Mateosmerodes/Mini_Sumo_Robot_LHDLT/README.md

# Mini_Sumo_Robot_LHDLT
Repositorio de informacion y código proyecto minisumo
