Mateosmerodes/Mini_Sumo_Robot_LHDLT/ficha_técnica_robot.docx

#### FICHA TÉCNICA

Nombre del Equipo/Robot: Hombres De Las Tabernas

Licencia de Hardware Libre: [CERN-OHL-P]

Enlace al Repositorio del Proyecto: GitHub (https://github.com/Mateosmerodes/Mini_Sumo_Robot_LHDLT)

#### 2. ESPECIFICACIÓNS MECÁNICAS

Parámetro | Valor Nominal
Dimensiones (ancho x largo x alto) | 9.8 x 9.8 x 5.5 cm
Masa total (con batería) | 420 g
Material do chasis | PCB de FR4, piezas de PetG, cuchilla de acero
Tipo de tracción | 4WD
Superficie de rodas | Silicona

#### 3. SISTEMA ELÉCTRICO Y DE POTENCIA

##### 3.1. Fuente de Alimentación (Batería)

- Tipo: LiPo 2S
- Tensión nominal: 7.4 (2*3.7) V
- Tensión máxima a plena carga: 8.4 V
- Capacidad: 4.50 mAh
- Tasa de descarga (C-Rating): [30] C
- Protección Eléctrica: MOSFET P AOD4185 contra inversión de polaridad · fusible rápido de 10 A (2512) · limitación de corriente por hardware en cada driver (ITRIP ≈ 2,4 A) · medida de tensión de batería (divisor 100 k / 33 k al ADC) para el aviso de batería baja (3,3 V por celda) · apagado por subtensión y temperatura en los drivers

##### 3.2. Actuadores (Motores y Drivers)

- Modelo / Tipo de motor: N20 Micro motoreductor
- Tensión de trabajo: [6,6–8,4] V
- Consumo a bloqueo (Stall Current): 2,2 A a 8,4 V por motor
- Controlador de motores (Driver): TI DRV8874
- Rango de tensiones admitidas (Driver): 4,5–37 V
- Corriente máxima soportada por canal: 2.1 A continuos / 6 A pico

##### 3.3. Consumo Eléctrico Estimado

- Potencia máxima calculada: 79 W
- Autonomía estimada en combate continuo: 5 minutos
- Fundamento del cálculo de autonomía:

#### 4. SISTEMA DE CONTROL Y SENSADO

Descripción elemento | Tipo / Modelo | Tensiones Admitidas y de Operación | Corriente nominal
Placa de Control Abierta | Espressif ESP32-S3-DevKitC-1 | 5 V | 100mA
Módulo del Receptor IR | VS1838B / TSOP38238 | 3.3 V | 1mA
Sensores de Borde (Línea) | QRE1113 analógico (módulo), × 4: 2 delante y 2 detrás | 3.3 V | 21mA
Sensores de Oponente | VL53L0X ToF (módulo GY-VL53L0XV2), × 6: 3 frontales, 2 laterales, 1 trasero | 3.3 V | 19mA
…

#### 5. INSPECCIÓN REGULATORIA Y SEGURIDAD

Criterio | Estado | Notas del Inspector
1. Dispositivos de Interferencia (Jamming) No incluye emisores (como LED’s IR de alta potencia) destinados a saturar o cegar los sensores del oponente. | [x] CUMPLE [ ] NO CUMPLE
2. Daño al Dohyo o al Oponente/Operador Ausencia de partes filosas, punzantes o mecanismos diseñados para romper el Dohyo o causar daño intencionado al robot rival o al operador (golpes de combate normal permitidos). | [x] CUMPLE [ ] NO CUMPLE
3. Fluidos, Polvo, Gas u Otras Sustancias Sin contenedores ni mecanismos que almacenen o proyecten líquidos, gases, polvos o sustancias sobre el oponente o la pista. | [x] CUMPLE [ ] NO CUMPLE
4. Pirotecnia Totalmente libre de dispositivos pirotécnicos, chispas o elementos inflamables. | [x] CUMPLE [ ] NO CUMPLE
5. Lanzamiento de Objetos Sin mecanismos que lancen proyectiles u objetos de cualquier tipo hacia el oponente. | [x] CUMPLE [ ] NO CUMPLE
6. Sustancias Pegajosas Ruedas y chasis libres de sustancias químicas adherentes o pegajosas para aumentar la tracción. | [x] CUMPLE [ ] NO CUMPLE
7. Incremento Artificial de "Efecto Suelo" Prohibido el uso de bombas de vacío, succión activa o imanes/electroimanes para aumentar la adherencia a la pista. | [x] CUMPLE [ ] NO CUMPLE
8. Fuente de Energía Permitida La energía proviene exclusivamente de pilas o baterías eléctricas (sin motores térmicos, muelles cargados previamente como fuente principal, etc.). | [x] CUMPLE [ ] NO CUMPLE
9. Dimensiones y Masa (Límites Estándar) Masa $\le 500\text{ g}$ y dimensiones iniciales $\le 10\text{ cm} \times 10\text{ cm}$ (sin límite de altura). | [x] CUMPLE [ ] NO CUMPLE
10. Sistema de Arranque por Infrarrojos / Retardo Responde al sistema de arranque oficial IR (o retardo obligatorio de 5 s inmóvil) e incluye Kill Switch accesible. | [x] CUMPLE [ ] NO CUMPLE
11. Filosofía Hardware Libre (No obligatoria) Placa de control basada en tecnología abierta con documentación/repositorio accesible. | [x] CUMPLE [ ] NO CUMPLE
