Mateosmerodes/Mini_Sumo_Robot_LHDLT/Robot_Mini-Sumo/docs/img/3d_planta.png

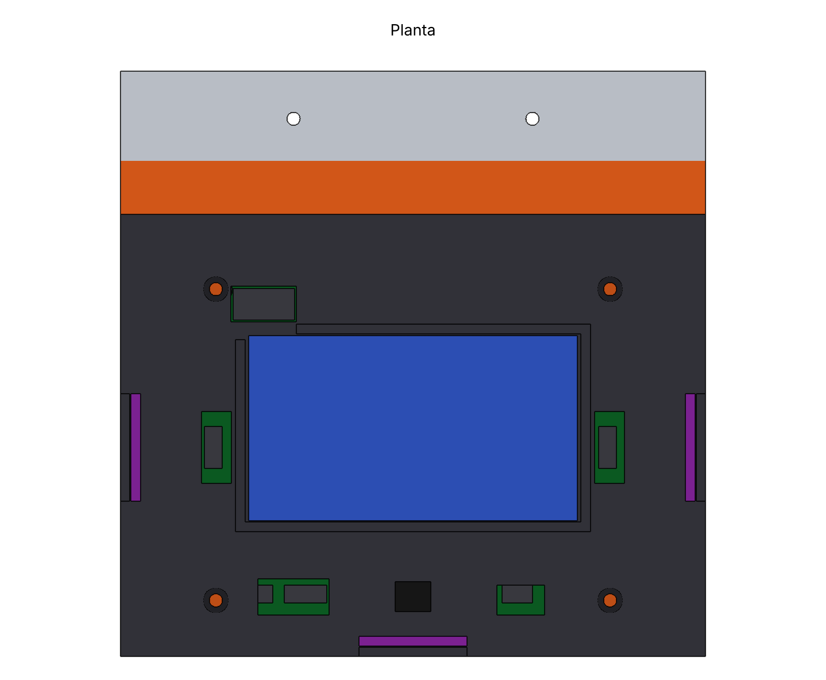
Robot_Mini-Sumo/docs/img/3d_planta.png
