Mateosmerodes/Mini_Sumo_Robot_LHDLT/Robot_Mini-Sumo/docs/img/pcb_cara_superior.png

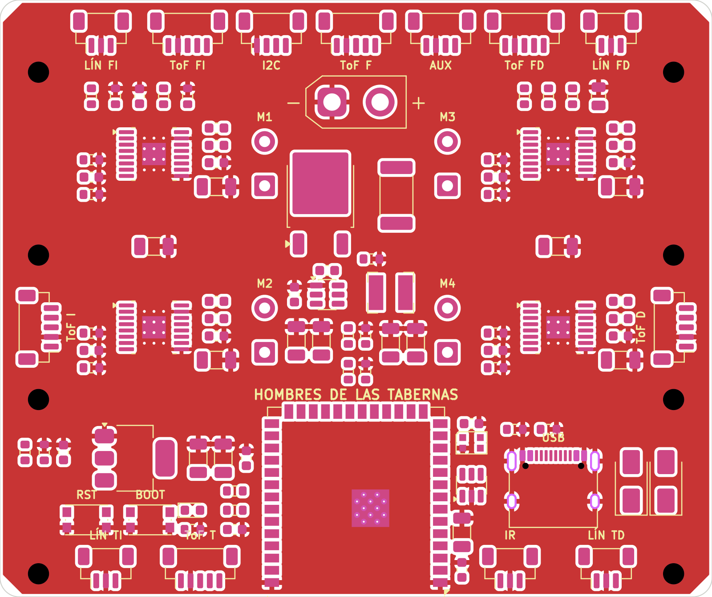
Robot_Mini-Sumo/docs/img/pcb_cara_superior.png
