Mateosmerodes/Mini_Sumo_Robot_LHDLT/Robot_Mini-Sumo/hardware/mecanica/step/robot_ensamblaje.step

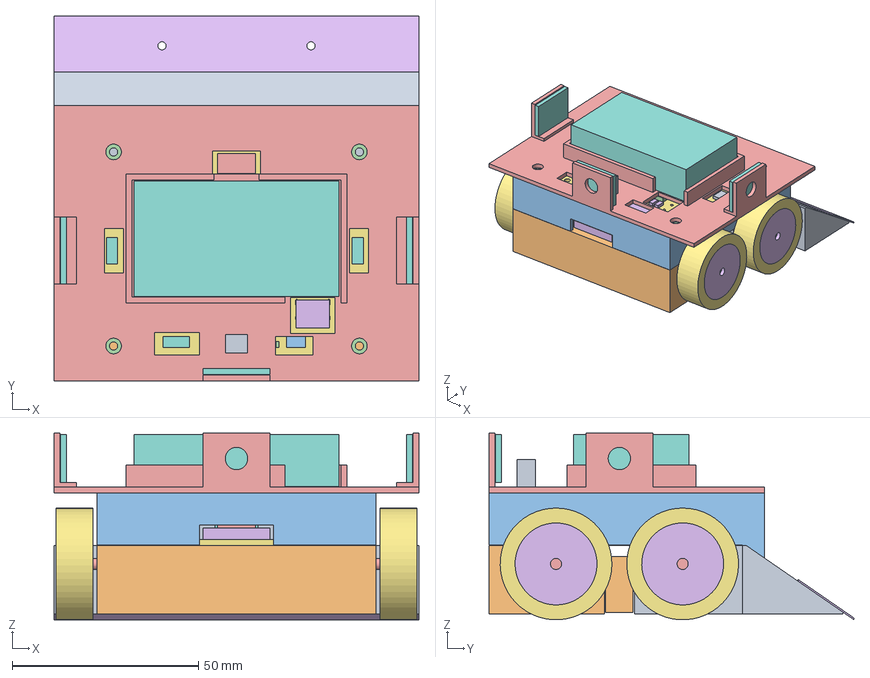
[picture p12: CAD file, 2026-10-06]
Robot_Mini-Sumo/hardware/mecanica/step/robot_ensamblaje.step
98.0 x 98.0 x 50.1 mm
frontal_rampa_cuna
trasera_cuna_parachoques
carcasa_paredes
carcasa_techo
cuchilla_acero
pcb
bateria_lipo_2s
receptor_ir
lastre_central
lastre_canal_del
lastre_canal_tras
motor_izq_del
llanta_izq_del
neumatico_izq_del
motor_der_del
llanta_der_del
neumatico_der_del
motor_izq_tras
llanta_izq_tras
neumatico_izq_tras
motor_der_tras
llanta_der_tras
neumatico_der_tras
tof_F_izq
tof_F
tof_F_der
tof_izq
tof_der
tof_tras
qre_del_1
qre_del_2
qre_tras_1
qre_tras_2
componentes_pcb
