Mateosmerodes/Mini_Sumo_Robot_LHDLT/Robot_Mini-Sumo/hardware/mecanica/cad/_render/tof_F_izq.stl

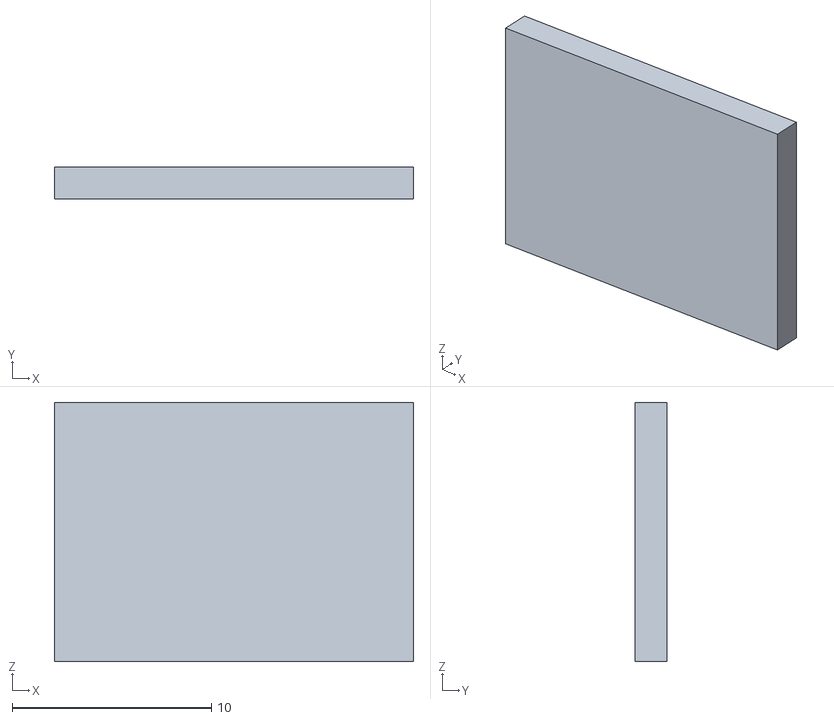
[picture p13: CAD file, 2026-10-06]
Robot_Mini-Sumo/hardware/mecanica/cad/_render/tof_F_izq.stl
18.0 x 1.60 x 13.0
