Mateosmerodes/Mini_Sumo_Robot_LHDLT/Robot_Mini-Sumo/hardware/mecanica/step/trasera_cuna_parachoques.step

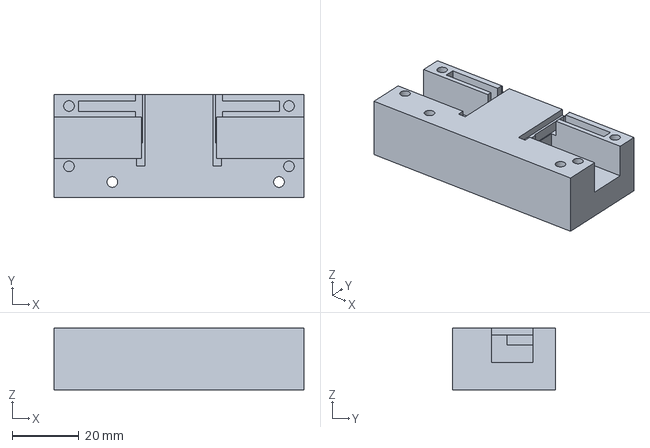
[picture p14: CAD file, 2026-10-19]
Robot_Mini-Sumo/hardware/mecanica/step/trasera_cuna_parachoques.step
75.0 x 31.0 x 18.5 mm
