Mateosmerodes/Mini_Sumo_Robot_LHDLT/Robot_Mini-Sumo/hardware/mecanica/cad/_render/qre_del_1.stl

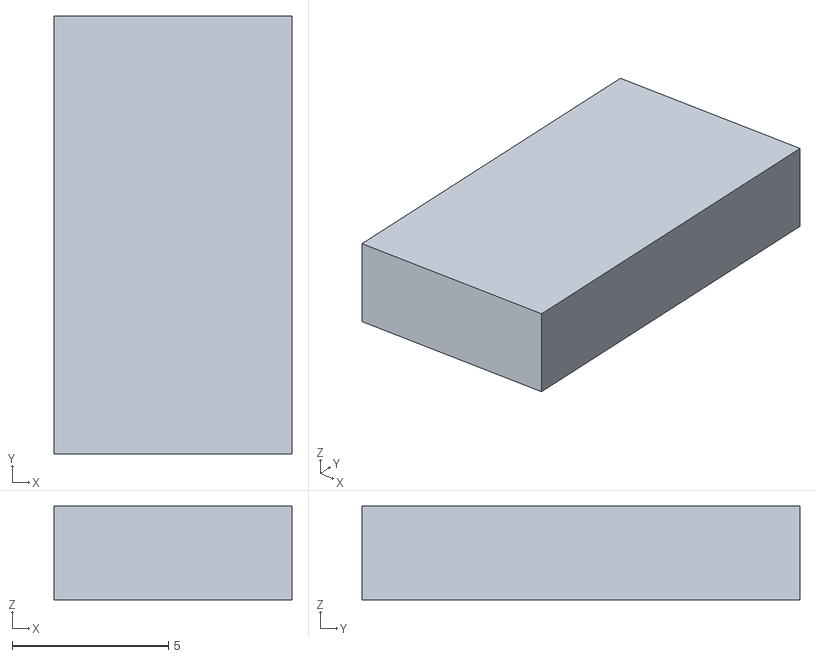
[picture p15: CAD file, 2026-10-06]
Robot_Mini-Sumo/hardware/mecanica/cad/_render/qre_del_1.stl
7.60 x 14.0 x 3.00
