Mateosmerodes/Mini_Sumo_Robot_LHDLT/Robot_Mini-Sumo/hardware/mecanica/step/pcb.step

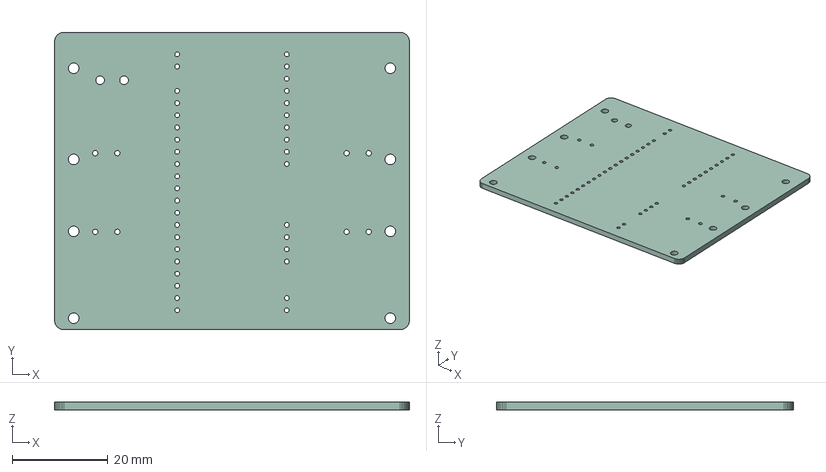
[picture p16: CAD file, 2026-10-19]
Robot_Mini-Sumo/hardware/mecanica/step/pcb.step
74.0 x 62.0 x 1.60 mm
