Mateosmerodes/Mini_Sumo_Robot_LHDLT/Robot_Mini-Sumo/hardware/mecanica/cad/_render/neumatico_izq_tras.stl

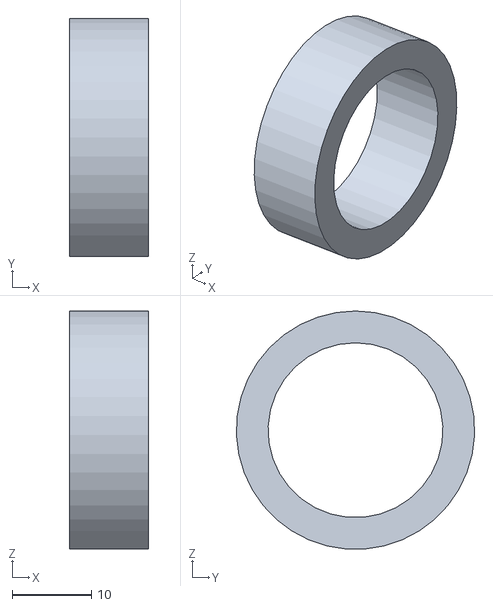
[picture p17: CAD file, 2026-10-06]
Robot_Mini-Sumo/hardware/mecanica/cad/_render/neumatico_izq_tras.stl
10.0 x 30.0 x 30.0
