Mateosmerodes/Mini_Sumo_Robot_LHDLT/Robot_Mini-Sumo/hardware/mecanica/step/carcasa_techo.step

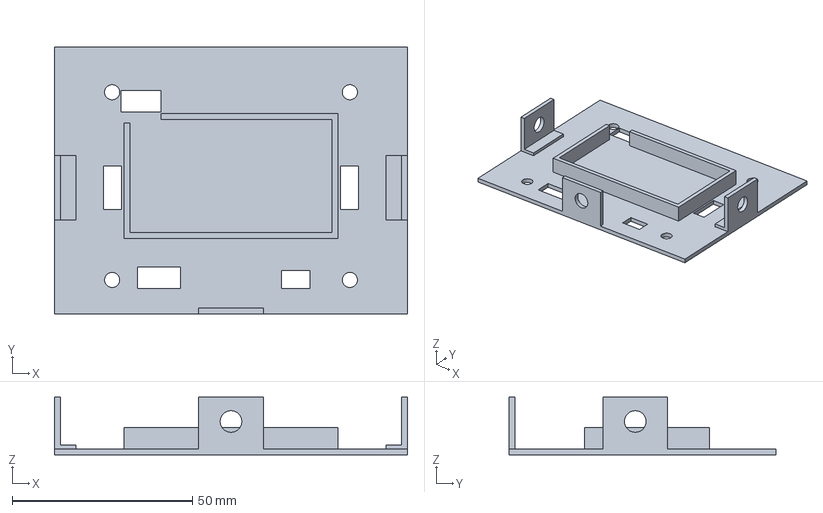
[picture p18: CAD file, 2026-10-19]
Robot_Mini-Sumo/hardware/mecanica/step/carcasa_techo.step
98.0 x 74.0 x 16.1 mm
