Mateosmerodes/Mini_Sumo_Robot_LHDLT/Robot_Mini-Sumo/hardware/mecanica/step/llanta.step

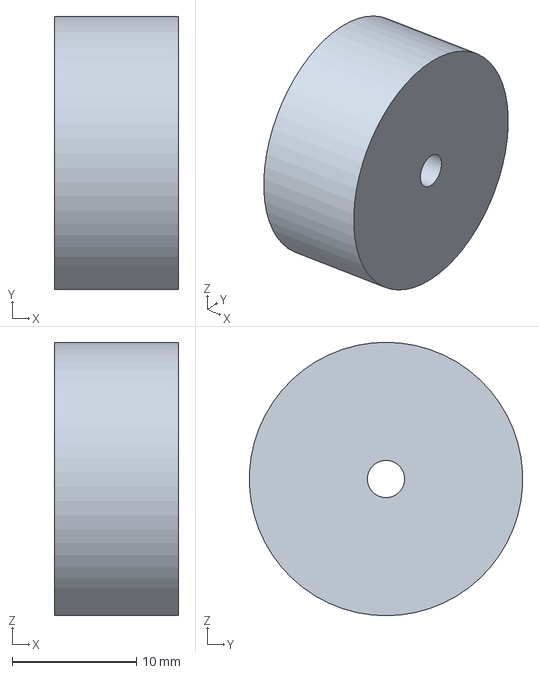
[picture p19: CAD file, 2026-10-06]
Robot_Mini-Sumo/hardware/mecanica/step/llanta.step
10.0 x 22.0 x 22.0 mm
