Mateosmerodes/Mini_Sumo_Robot_LHDLT/Robot_Mini-Sumo/hardware/mecanica/cad/_render/pcb.stl

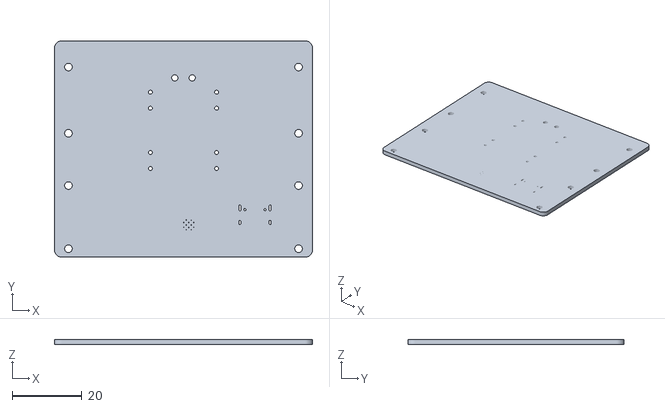
[picture p20: CAD file, 2026-10-06]
Robot_Mini-Sumo/hardware/mecanica/cad/_render/pcb.stl
74.0 x 62.0 x 1.51
