Mateosmerodes/Mini_Sumo_Robot_LHDLT/Robot_Mini-Sumo/hardware/mecanica/step/carcasa_paredes.step

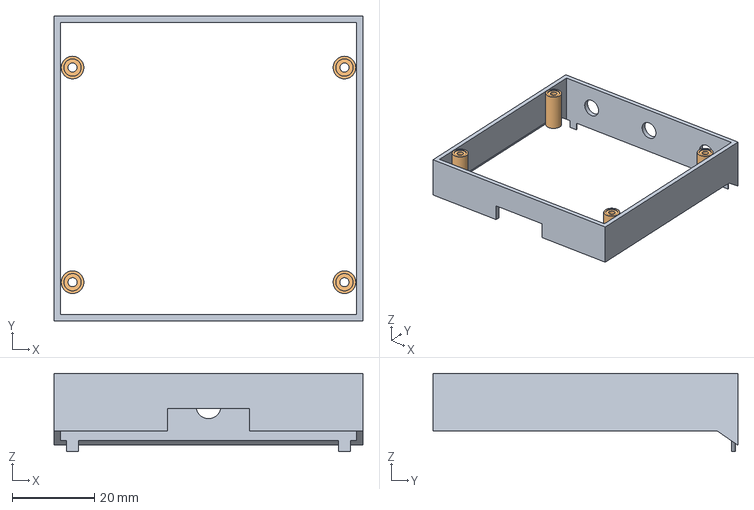
[picture p21: CAD file, 2026-10-06]
Robot_Mini-Sumo/hardware/mecanica/step/carcasa_paredes.step
75.0 x 74.0 x 19.0 mm
