Mateosmerodes/Mini_Sumo_Robot_LHDLT/Robot_Mini-Sumo/hardware/mecanica/step/frontal_rampa_cuna.step

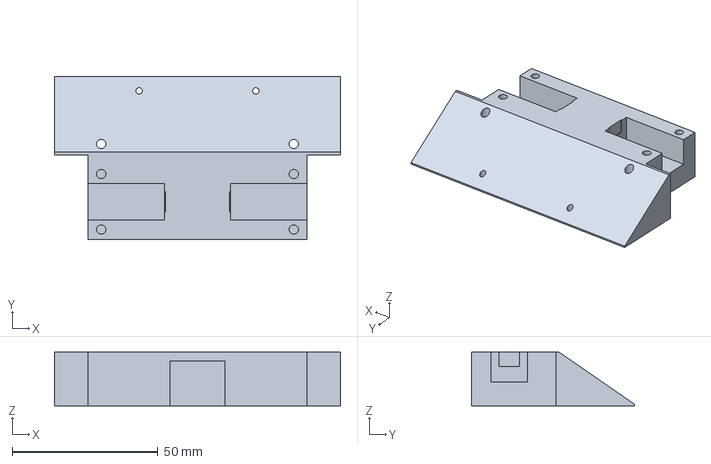
[picture p22: CAD file, 2026-10-06]
Robot_Mini-Sumo/hardware/mecanica/step/frontal_rampa_cuna.step
98.0 x 56.0 x 18.5 mm
