Mateosmerodes/Mini_Sumo_Robot_LHDLT/Robot_Mini-Sumo/hardware/mecanica/cad/_render/componentes_pcb.stl

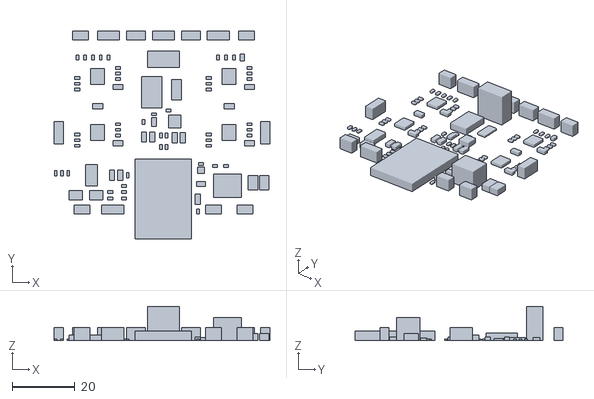
[picture p23: CAD file, 2026-10-06]
Robot_Mini-Sumo/hardware/mecanica/cad/_render/componentes_pcb.stl
69.0 x 66.6 x 11.0
