Mateosmerodes/Mini_Sumo_Robot_LHDLT/Robot_Mini-Sumo/hardware/mecanica/cad/_render/motor_izq_del.stl

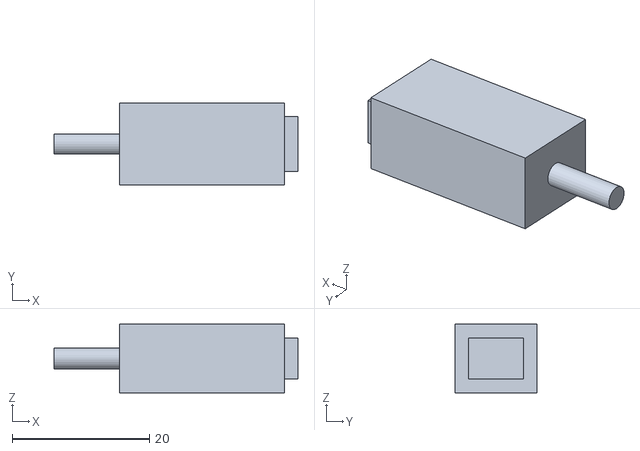
[picture p24: CAD file, 2026-10-06]
Robot_Mini-Sumo/hardware/mecanica/cad/_render/motor_izq_del.stl
35.5 x 12.0 x 10.0
