Mateosmerodes/Mini_Sumo_Robot_LHDLT/Robot_Mini-Sumo/hardware/mecanica/cad/_render/bateria_lipo_2s.stl

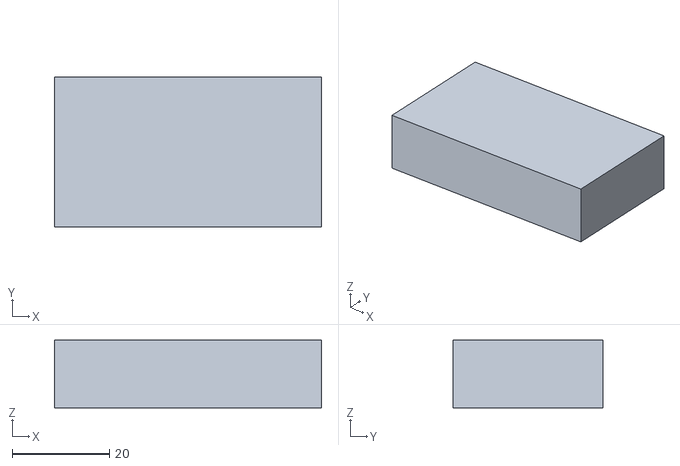
[picture p25: CAD file, 2026-10-06]
Robot_Mini-Sumo/hardware/mecanica/cad/_render/bateria_lipo_2s.stl
55.0 x 31.0 x 14.0
