Mateosmerodes/Mini_Sumo_Robot_LHDLT/Robot_Mini-Sumo/hardware/mecanica/cad/_render/lastre_canal_del.stl

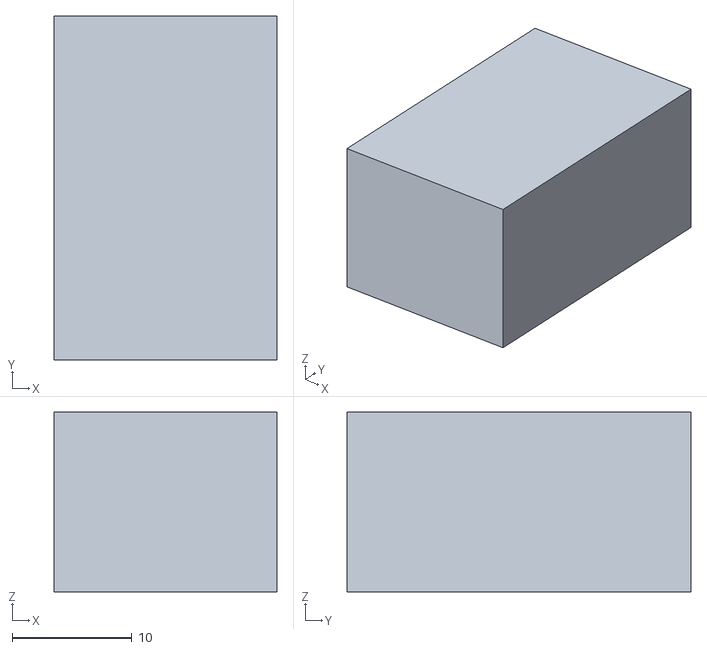
[picture p26: CAD file, 2026-10-06]
Robot_Mini-Sumo/hardware/mecanica/cad/_render/lastre_canal_del.stl
18.6 x 28.7 x 15.0
