Mateosmerodes/Mini_Sumo_Robot_LHDLT/Robot_Mini-Sumo/hardware/mecanica/cad/_render/receptor_ir.stl

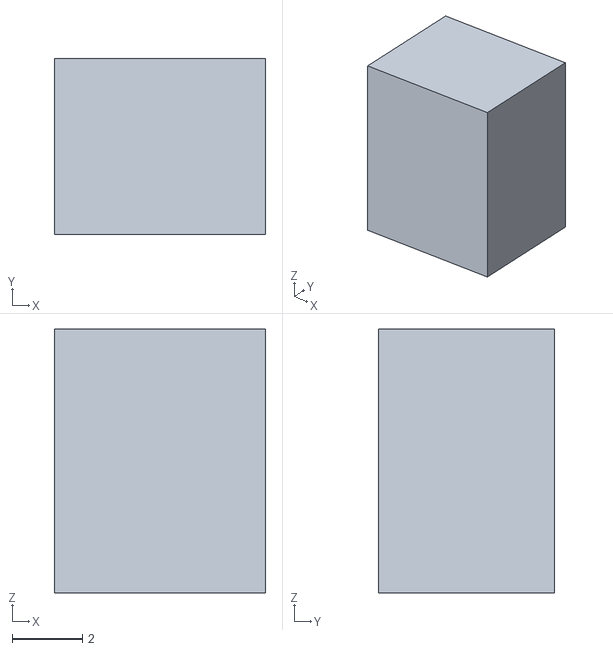
[picture p27: CAD file, 2026-10-06]
Robot_Mini-Sumo/hardware/mecanica/cad/_render/receptor_ir.stl
6.00 x 5.00 x 7.50
