Mateosmerodes/Mini_Sumo_Robot_LHDLT/Robot_Mini-Sumo/hardware/mecanica/cad/_render/carcasa_superior.stl

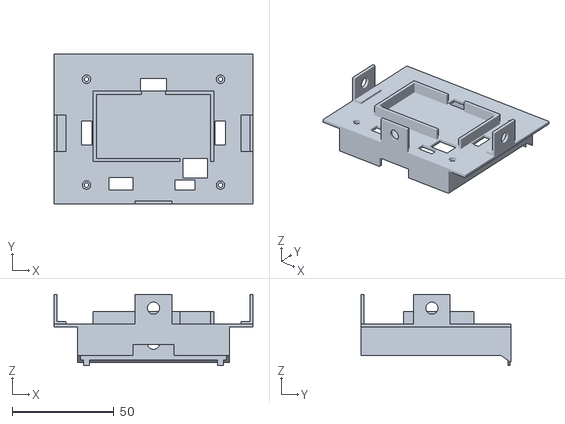
[picture p28: CAD file, 2026-10-06]
Robot_Mini-Sumo/hardware/mecanica/cad/_render/carcasa_superior.stl
98.0 x 74.0 x 35.1
