Mateosmerodes/Mini_Sumo_Robot_LHDLT/Robot_Mini-Sumo/hardware/mecanica/cad/_render/cuchilla_acero.stl

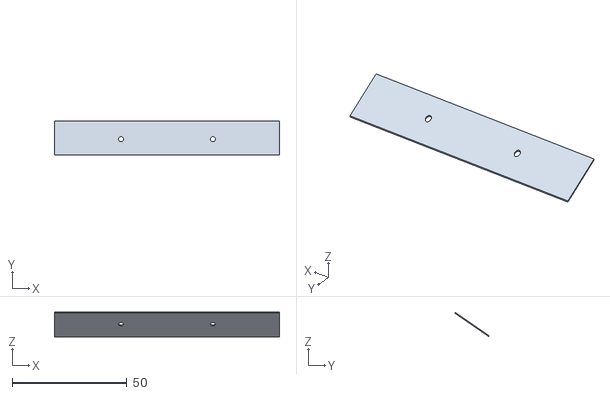
[picture p29: CAD file, 2026-10-06]
Robot_Mini-Sumo/hardware/mecanica/cad/_render/cuchilla_acero.stl
98.0 x 15.0 x 10.8
