Mateosmerodes/Mini_Sumo_Robot_LHDLT/Robot_Mini-Sumo/hardware/mecanica/cad/_render/lastre_canal_tras.stl

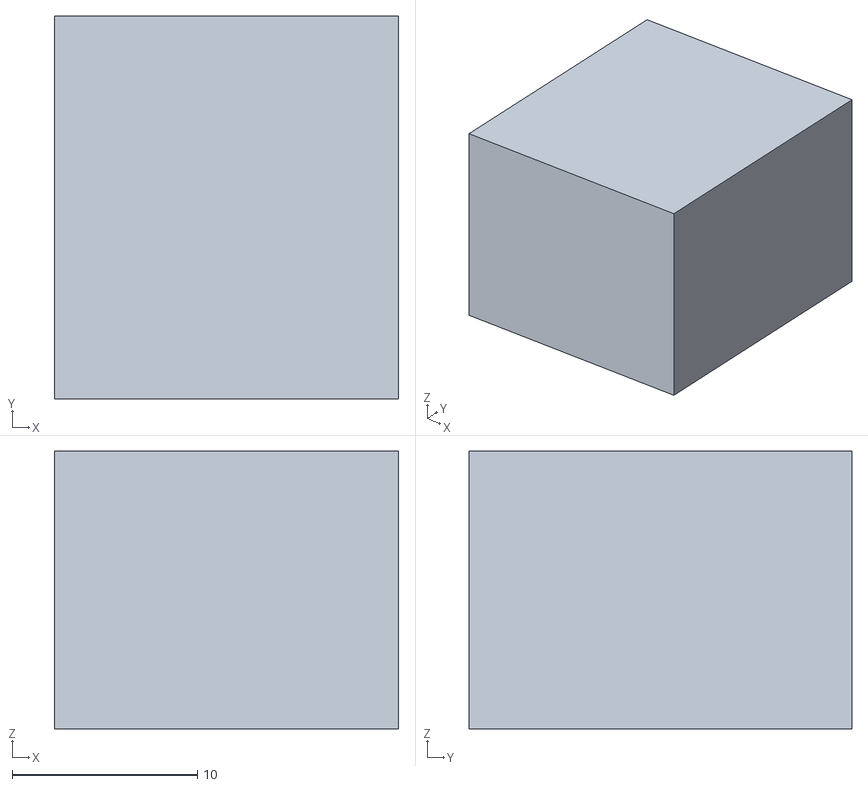
[picture p30: CAD file, 2026-10-06]
Robot_Mini-Sumo/hardware/mecanica/cad/_render/lastre_canal_tras.stl
18.6 x 20.7 x 15.0
