Mateosmerodes/Mini_Sumo_Robot_LHDLT/Robot_Mini-Sumo/hardware/mecanica/cad/_render/trasera_cuna_parachoques.stl

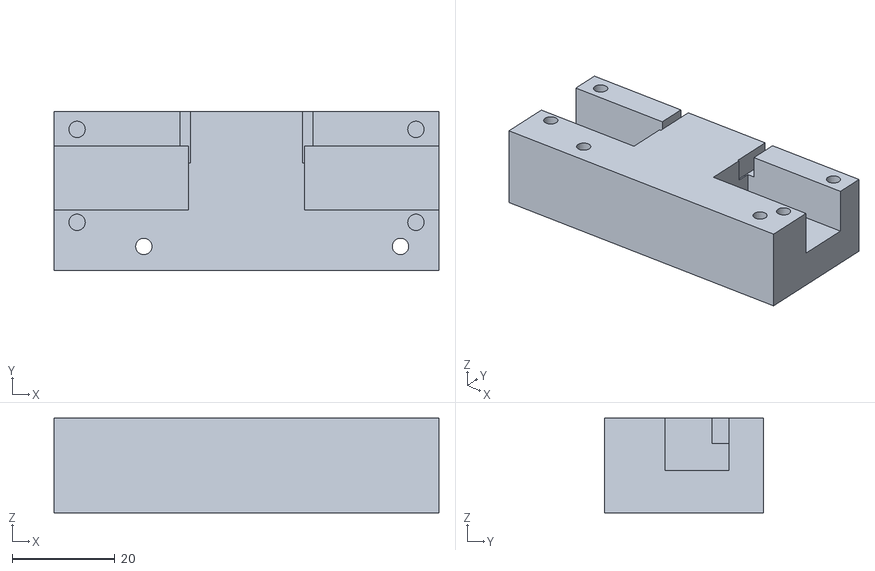
[picture p31: CAD file, 2026-10-06]
Robot_Mini-Sumo/hardware/mecanica/cad/_render/trasera_cuna_parachoques.stl
75.0 x 31.0 x 18.5
