Mateosmerodes/Mini_Sumo_Robot_LHDLT/Robot_Mini-Sumo/hardware/mecanica/cad/_render/lastre_central.stl

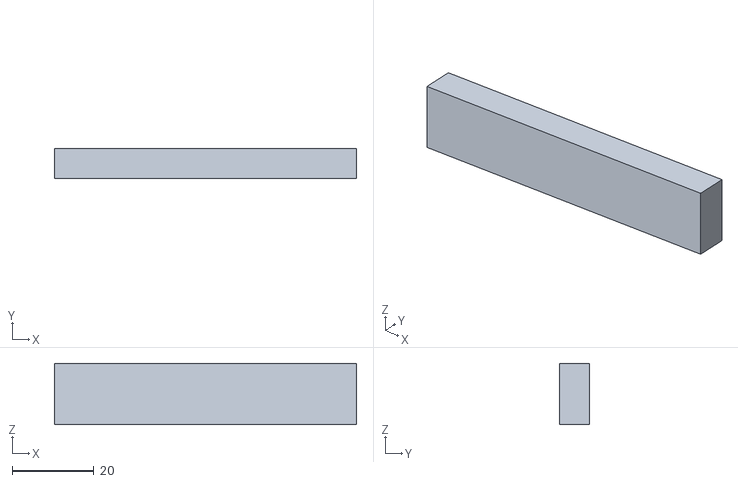
[picture p32: CAD file, 2026-10-06]
Robot_Mini-Sumo/hardware/mecanica/cad/_render/lastre_central.stl
74.0 x 7.40 x 15.0
