Mateosmerodes/Mini_Sumo_Robot_LHDLT/(list of files, cad)

Other CAD files:
Robot_Mini-Sumo/hardware/mecanica/cad/robot_sumo.FCStd
Robot_Mini-Sumo/hardware/mecanica/cad/_render/qre_del_2.stl
Robot_Mini-Sumo/hardware/mecanica/cad/_render/tof_izq.stl
Robot_Mini-Sumo/hardware/mecanica/cad/_render/carcasa_techo.stl
Robot_Mini-Sumo/hardware/mecanica/cad/_render/llanta_der_del.stl
Robot_Mini-Sumo/hardware/mecanica/cad/_render/frontal_rampa_cuna.stl
Robot_Mini-Sumo/hardware/mecanica/cad/_render/tof_F.stl
Robot_Mini-Sumo/hardware/mecanica/cad/_render/qre_tras_1.stl
Robot_Mini-Sumo/hardware/mecanica/cad/_render/llanta_izq_tras.stl
Robot_Mini-Sumo/hardware/mecanica/cad/_render/neumatico_izq_del.stl
Robot_Mini-Sumo/hardware/mecanica/cad/_render/llanta_der_tras.stl
Robot_Mini-Sumo/hardware/mecanica/cad/_render/llanta_izq_del.stl
Robot_Mini-Sumo/hardware/mecanica/cad/_render/motor_der_tras.stl
Robot_Mini-Sumo/hardware/mecanica/cad/_render/carcasa_paredes.stl
Robot_Mini-Sumo/hardware/mecanica/cad/_render/tof_tras.stl
Robot_Mini-Sumo/hardware/mecanica/cad/_render/tof_der.stl
Robot_Mini-Sumo/hardware/mecanica/cad/_render/motor_der_del.stl
Robot_Mini-Sumo/hardware/mecanica/cad/_render/neumatico_der_del.stl
Robot_Mini-Sumo/hardware/mecanica/cad/_render/motor_izq_tras.stl
Robot_Mini-Sumo/hardware/mecanica/cad/_render/neumatico_der_tras.stl
Robot_Mini-Sumo/hardware/mecanica/cad/_render/qre_tras_2.stl
Robot_Mini-Sumo/hardware/mecanica/cad/_render/tof_F_der.stl
Robot_Mini-Sumo/hardware/mecanica/stl/carcasa_paredes.stl
Robot_Mini-Sumo/hardware/mecanica/stl/carcasa_techo.stl
Robot_Mini-Sumo/hardware/mecanica/stl/frontal_rampa_cuna.stl
Robot_Mini-Sumo/hardware/mecanica/stl/llanta.stl
Robot_Mini-Sumo/hardware/mecanica/stl/trasera_cuna_parachoques.stl
