Mateosmerodes/Mini_Sumo_Robot_LHDLT/(list of files, drawings)

Other design files:
Robot_Mini-Sumo/hardware/mecanica/cad/pcb_componentes.json
