Mateosmerodes/Mini_Sumo_Robot_LHDLT/Robot_Mini-Sumo/hardware/pcb/robot_sumo.kicad_pcb

## KiCad design Robot_Mini-Sumo/hardware/pcb/robot_sumo.kicad_pcb (2026-10-06)

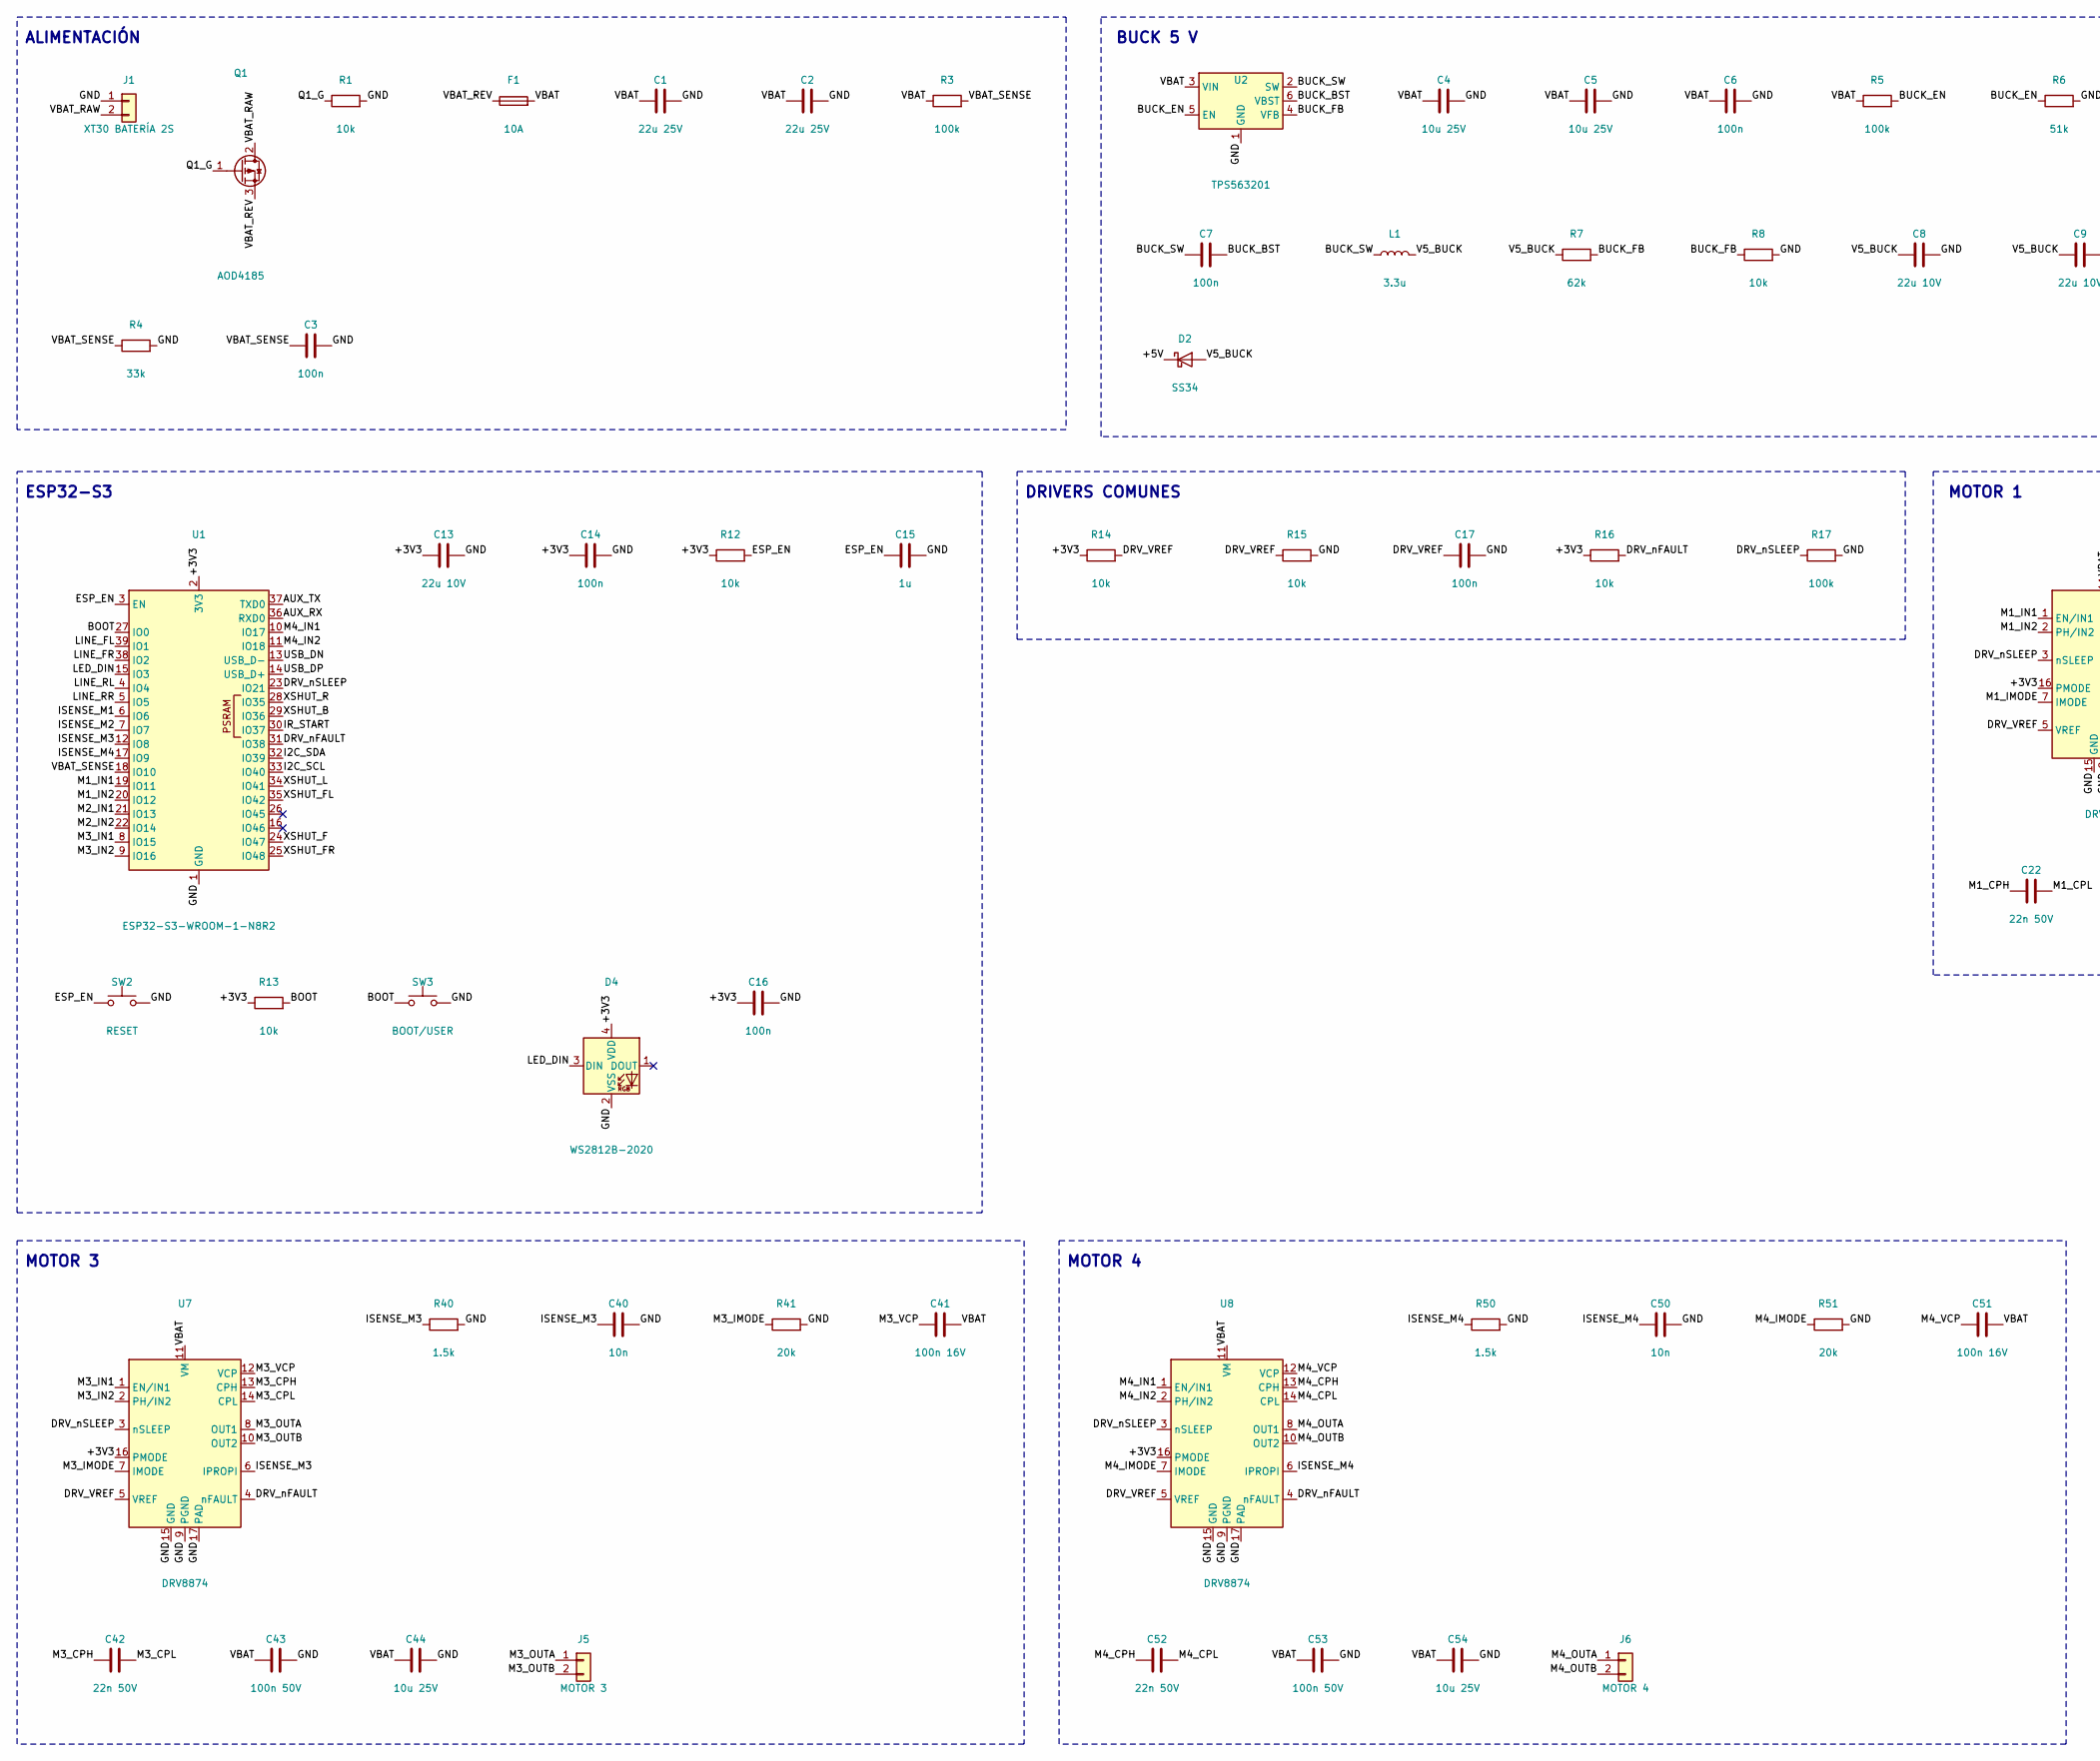
[picture p33: schematic robot_sumo.kicad_sch, Robot Mini-Sumo · Placa base, part in row 1, column 1]

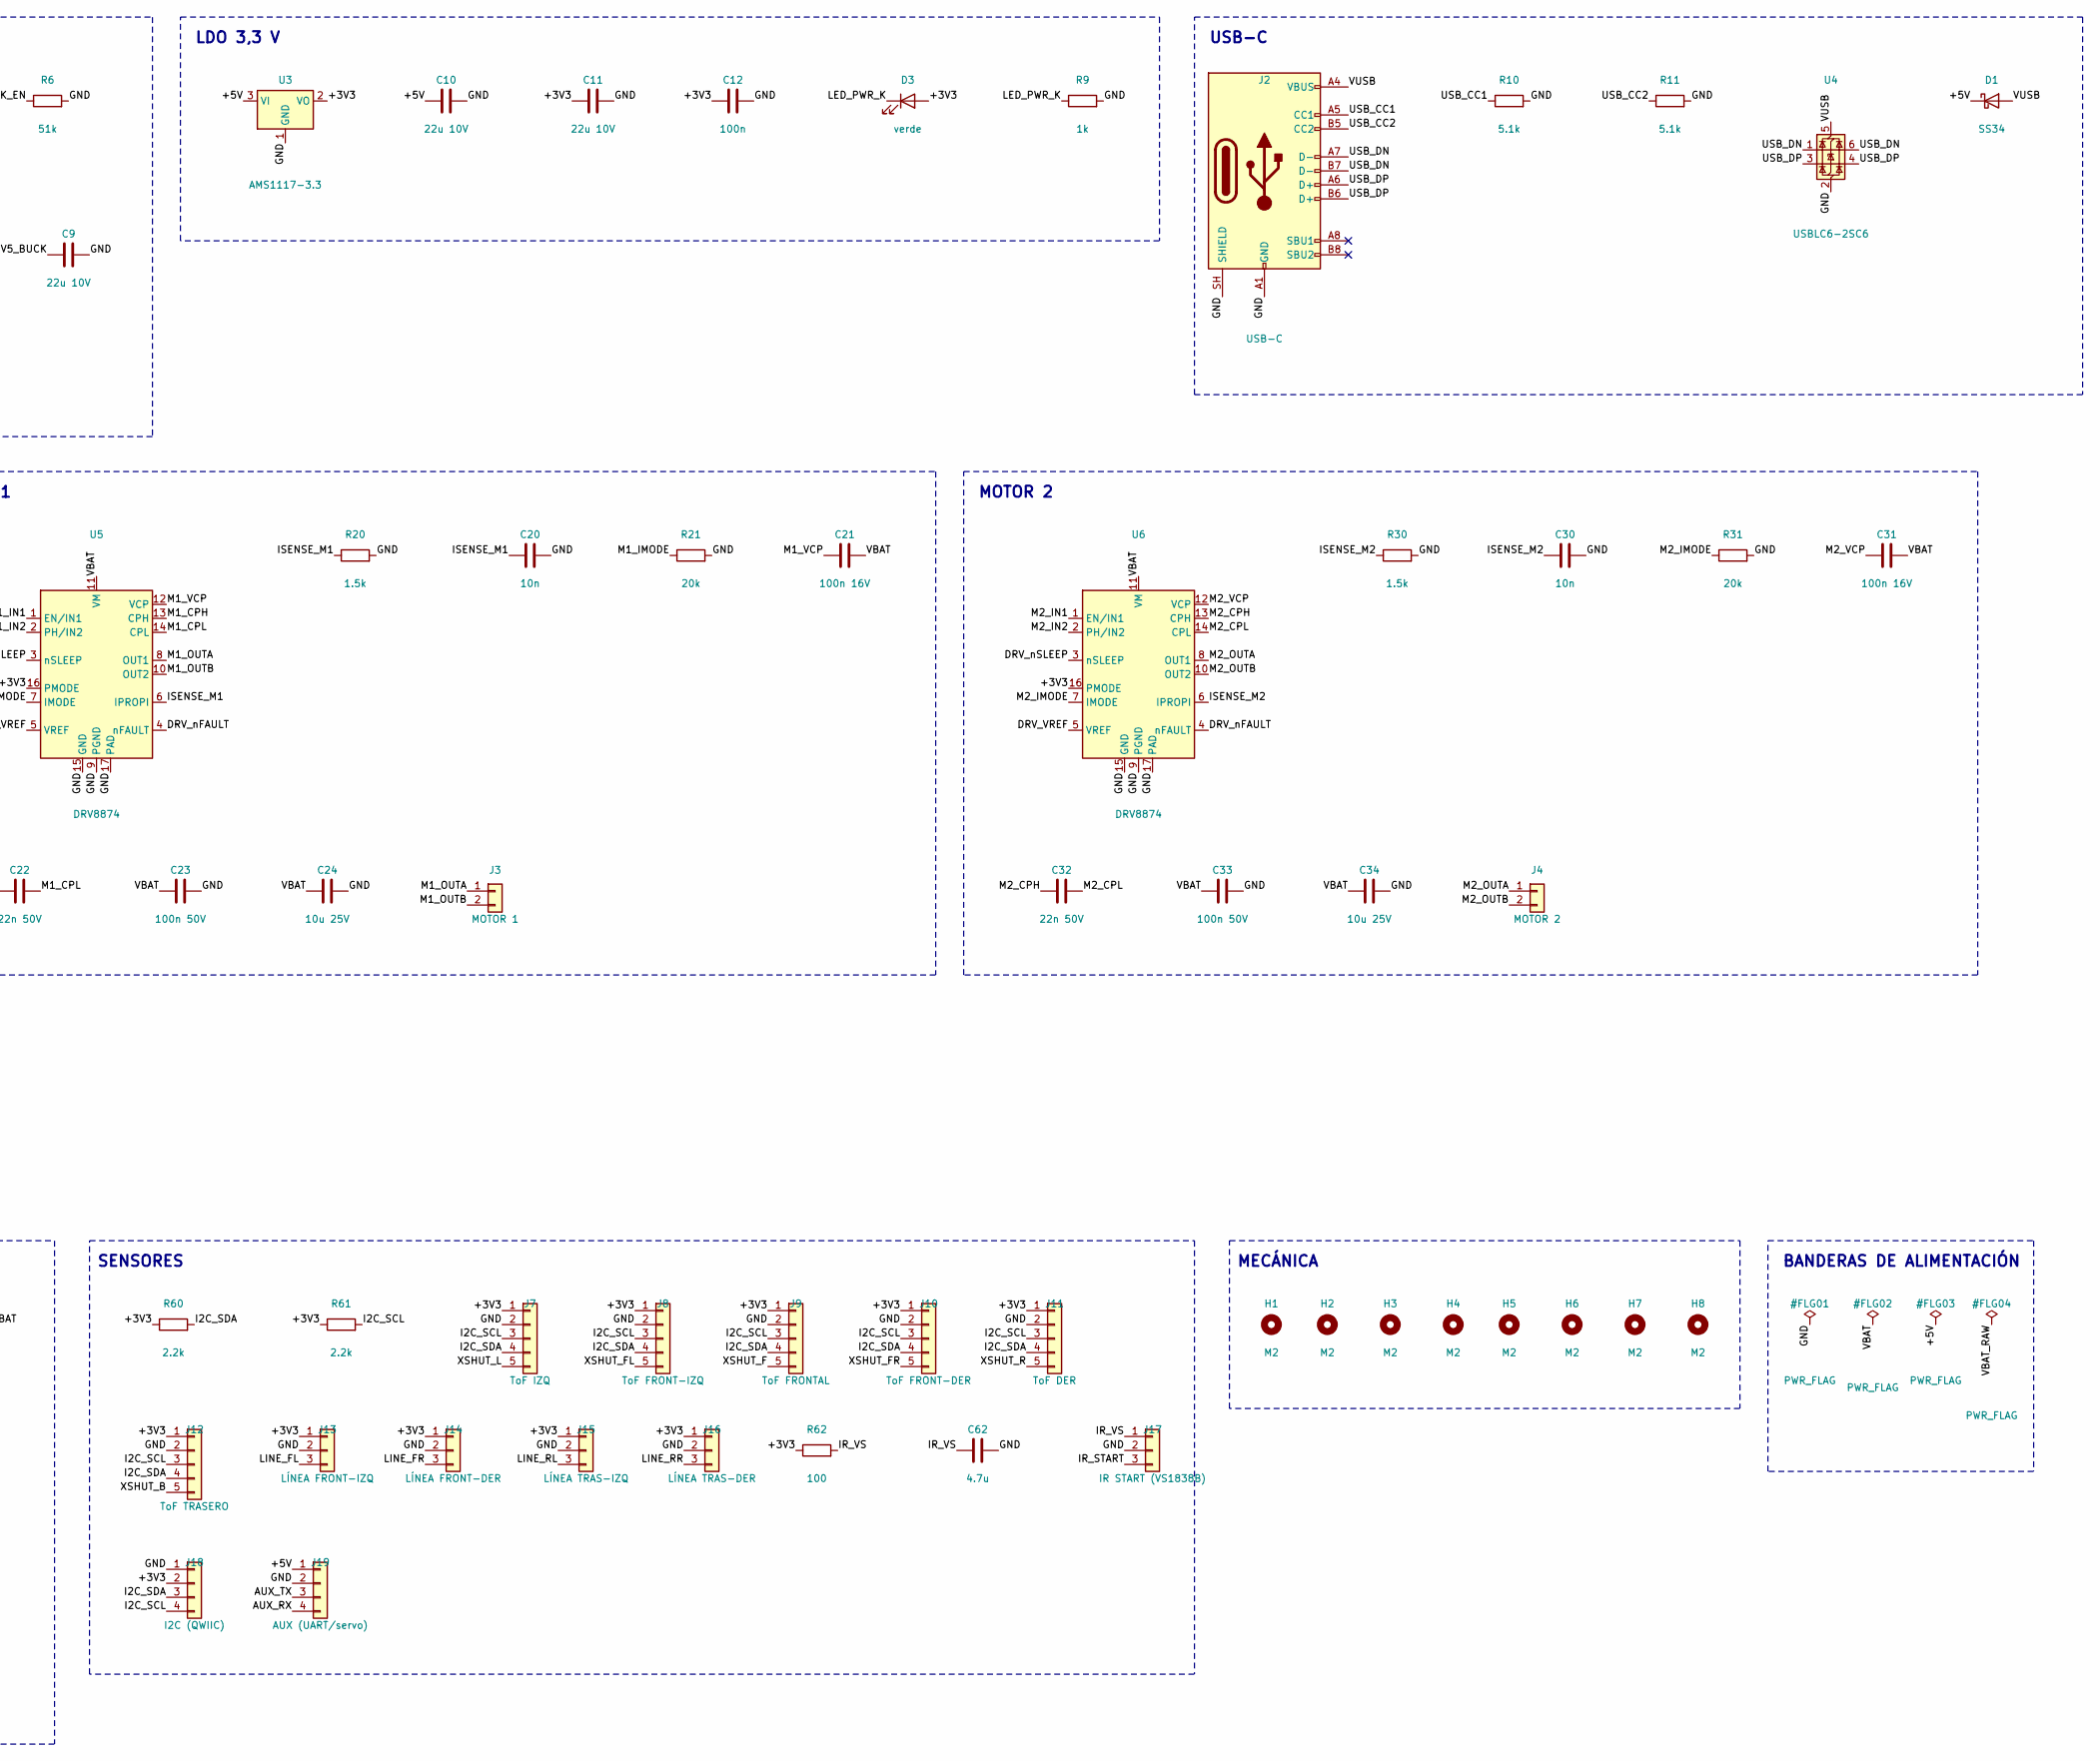
[picture p34: schematic robot_sumo.kicad_sch, Robot Mini-Sumo · Placa base, part in row 1, column 2]

Parts:
C1, C2: 22u 25V; C_1206_3216Metric
C3, C6, C7, C12, C14, C16, C17: 100n; C_0603_1608Metric
C4, C5, C24, C34, C44, C54: 10u 25V; C_1206_3216Metric
C8, C9, C10, C11, C13: 22u 10V; C_1206_3216Metric
C15: 1u; C_0603_1608Metric
C20, C30, C40, C50: 10n; C_0603_1608Metric
C21, C31, C41, C51: 100n 16V; C_0603_1608Metric
C22, C32, C42, C52: 22n 50V; C_0603_1608Metric
C23, C33, C43, C53: 100n 50V; C_0603_1608Metric
C62: 4.7u; C_0805_2012Metric
D1, D2: SS34; D_SMA
D3: verde; LED_0603_1608Metric
D4: WS2812B-2020; LED_WS2812B-2020_PLCC4_2.0x2.0mm
F1: 10A; Fuse_2512_6332Metric; MPN Fusible rápido 2512 10 A
H1, H2, H3, H4, H5, H6, H7, H8: M2; MountingHole_2.2mm_M2
J1: XT30 BATERÍA 2S; AMASS_XT30UPB-M_1x02_P5.0mm_Vertical; MPN AMASS XT30UPB-M (macho, vertical PCB)
J2: USB-C; USB_C_Receptacle_XKB_U262-16XN-4BVC11; MPN XKB U262-161N-4BVC11 (USB-C vertical)
J3: MOTOR 1; SolderWire-0.5sqmm_1x02_P4.6mm_D0.9mm_OD2.1mm; MPN Cable del motor soldado (entra por abaj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
J4: MOTOR 2; SolderWire-0.5sqmm_1x02_P4.6mm_D0.9mm_OD2.1mm; MPN Cable del motor soldado (entra por abaj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
J5: MOTOR 3; SolderWire-0.5sqmm_1x02_P4.6mm_D0.9mm_OD2.1mm; MPN Cable del motor soldado (entra por abaj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
J6: MOTOR 4; SolderWire-0.5sqmm_1x02_P4.6mm_D0.9mm_OD2.1mm; MPN Cable del motor soldado (entra por abaj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
J7: ToF IZQ; JST_SH_BM05B-SRSS-TB_1x05-1MP_P1.00mm_Vertical; MPN JST SH 5P SMD vertical (BM05B-SRSS-TB)
J8: ToF FRONT-IZQ; JST_SH_BM05B-SRSS-TB_1x05-1MP_P1.00mm_Vertical; MPN JST SH 5P SMD vertical (BM05B-SRSS-TB)
J9: ToF FRONTAL; JST_SH_BM05B-SRSS-TB_1x05-1MP_P1.00mm_Vertical; MPN JST SH 5P SMD vertical (BM05B-SRSS-TB)
J10: ToF FRONT-DER; JST_SH_BM05B-SRSS-TB_1x05-1MP_P1.00mm_Vertical; MPN JST SH 5P SMD vertical (BM05B-SRSS-TB)
J11: ToF DER; JST_SH_BM05B-SRSS-TB_1x05-1MP_P1.00mm_Vertical; MPN JST SH 5P SMD vertical (BM05B-SRSS-TB)
J12: ToF TRASERO; JST_SH_BM05B-SRSS-TB_1x05-1MP_P1.00mm_Vertical; MPN JST SH 5P SMD vertical (BM05B-SRSS-TB)
J13: LÍNEA FRONT-IZQ; JST_SH_BM03B-SRSS-TB_1x03-1MP_P1.00mm_Vertical; MPN JST SH 3P SMD vertical (BM03B-SRSS-TB)
J14: LÍNEA FRONT-DER; JST_SH_BM03B-SRSS-TB_1x03-1MP_P1.00mm_Vertical; MPN JST SH 3P SMD vertical (BM03B-SRSS-TB)
J15: LÍNEA TRAS-IZQ; JST_SH_BM03B-SRSS-TB_1x03-1MP_P1.00mm_Vertical; MPN JST SH 3P SMD vertical (BM03B-SRSS-TB)
J16: LÍNEA TRAS-DER; JST_SH_BM03B-SRSS-TB_1x03-1MP_P1.00mm_Vertical; MPN JST SH 3P SMD vertical (BM03B-SRSS-TB)
J17: IR START (VS1838B); JST_SH_BM03B-SRSS-TB_1x03-1MP_P1.00mm_Vertical; MPN JST SH 3P SMD vertical (BM03B-SRSS-TB)
J18: I2C (QWIIC); JST_SH_BM04B-SRSS-TB_1x04-1MP_P1.00mm_Vertical; MPN JST SH 4P SMD vertical (BM04B-SRSS-TB)
J19: AUX (UART/servo); JST_SH_BM04B-SRSS-TB_1x04-1MP_P1.00mm_Vertical; MPN JST SH 4P SMD vertical (BM04B-SRSS-TB)
L1: 3.3u; L_Bourns-SRN4018; MPN SRN4018-3R3M (3,3 µH, Isat ≥ 2,5 A)
Q1: AOD4185; TO-252-2; MPN AOD4185 (-40 V, -40 A, 15 mΩ)
R1, R8, R12, R13, R14, R15, R16: 10k; R_0603_1608Metric
R3, R5, R17: 100k; R_0603_1608Metric
R4: 33k; R_0603_1608Metric
R6: 51k; R_0603_1608Metric
R7: 62k; R_0603_1608Metric
R9: 1k; R_0603_1608Metric
R10, R11: 5.1k; R_0603_1608Metric
R20, R30, R40, R50: 1.5k; R_0603_1608Metric
R21, R31, R41, R51: 20k; R_0603_1608Metric
R60, R61: 2.2k; R_0603_1608Metric
R62: 100; R_0603_1608Metric
SW2: RESET; SW_Push_1P1T_NO_CK_KMR2
SW3: BOOT/USER; SW_Push_1P1T_NO_CK_KMR2
U1: ESP32-S3-WROOM-1-N8R2; ESP32-S3-WROOM-1; MPN ESP32-S3-WROOM-1-N8R2 (NO usar variante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
U2: TPS563201; SOT-23-6; MPN TPS563201DDCR
U3: AMS1117-3.3; SOT-223-3_TabPin2; MPN AMS1117-3.3
U4: USBLC6-2SC6; SOT-23-6
U5, U6, U7, U8: DRV8874; HTSSOP-16-1EP_4.4x5mm_P0.65mm_EP3.4x5mm_Mask2.46x2.31mm; MPN DRV8874PWPR

Connections:
+3V3: C11.1, C12.1, C13.1, C14.1, C16.1, D3.2 (A), D4.4 (VDD), J7.1, J8.1, J9.1, J10.1, J11.1, J12.1, J13.1, J14.1, J15.1, J16.1, J18.2, R12.1, R13.1, R14.1, R16.1, R60.1, R61.1, R62.1, U1.2 (3V3), U3.2 (VO), U5.16 (PMODE), U6.16 (PMODE), U7.16 (PMODE), U8.16 (PMODE)
+5V: C10.1, D1.1 (K), D2.1 (K), J19.1, U3.3 (VI)
AUX_RX: J19.4, U1.36 (RXD0)
AUX_TX: J19.3, U1.37 (TXD0)
BOOT: R13.2, SW3.1, U1.27 (IO0)
BUCK_BST: C7.2, U2.6 (VBST)
BUCK_EN: R5.2, R6.1, U2.5 (EN)
BUCK_FB: R7.2, R8.1, U2.4 (VFB)
BUCK_SW: C7.1, L1.1, U2.2 (SW)
DRV_VREF: C17.1, R14.2, R15.1, U5.5 (VREF), U6.5 (VREF), U7.5 (VREF), U8.5 (VREF)
DRV_nFAULT: R16.2, U1.31 (IO38), U5.4 (nFAULT), U6.4 (nFAULT), U7.4 (nFAULT), U8.4 (nFAULT)
DRV_nSLEEP: R17.1, U1.23 (IO21), U5.3 (nSLEEP), U6.3 (nSLEEP), U7.3 (nSLEEP), U8.3 (nSLEEP)
ESP_EN: C15.1, R12.2, SW2.1, U1.3 (EN)
GND: C1.2, C2.2, C3.2, C4.2, C5.2, C6.2, C8.2, C9.2, C10.2, C11.2, C12.2, C13.2, C14.2, C15.2, C16.2, C17.2, C20.2, C23.2, C24.2, C30.2, C33.2, C34.2, C40.2, C43.2, C44.2, C50.2, C53.2, C54.2, C62.2, D4.2 (VSS), J1.1, J2.A1 (GND), J2.A12 (GND), J2.B1 (GND), J2.B12 (GND), J2.SH (SHIELD), J7.2, J8.2, J9.2, J10.2, J11.2, J12.2, J13.2, J14.2, J15.2, J16.2, J17.2, J18.1, J19.2, R1.2, R4.2, R6.2, R8.2, R9.2, R10.2, R11.2, R15.2, R17.2, R20.2, R21.2, R30.2, R31.2, R40.2, R41.2, R50.2, R51.2, SW2.2, SW3.2, U1.1 (GND), U1.40 (GND), U1.41 (GND), U2.1 (GND), U3.1 (GND), U4.2 (GND), U5.9 (PGND), U5.15 (GND), U5.17 (PAD), U6.9 (PGND), U6.15 (GND), U6.17 (PAD), U7.9 (PGND), U7.15 (GND), U7.17 (PAD), U8.9 (PGND), U8.15 (GND), U8.17 (PAD)
I2C_SCL: J7.3, J8.3, J9.3, J10.3, J11.3, J12.3, J18.4, R61.2, U1.33 (IO40)
I2C_SDA: J7.4, J8.4, J9.4, J10.4, J11.4, J12.4, J18.3, R60.2, U1.32 (IO39)
IR_START: J17.3, U1.30 (IO37)
IR_VS: C62.1, J17.1, R62.2
ISENSE_M1: C20.1, R20.1, U1.6 (IO6), U5.6 (IPROPI)
ISENSE_M2: C30.1, R30.1, U1.7 (IO7), U6.6 (IPROPI)
ISENSE_M3: C40.1, R40.1, U1.12 (IO8), U7.6 (IPROPI)
ISENSE_M4: C50.1, R50.1, U1.17 (IO9), U8.6 (IPROPI)
LED_DIN: D4.3 (DIN), U1.15 (IO3)
LED_PWR_K: D3.1 (K), R9.1
LINE_FL: J13.3, U1.39 (IO1)
LINE_FR: J14.3, U1.38 (IO2)
LINE_RL: J15.3, U1.4 (IO4)
LINE_RR: J16.3, U1.5 (IO5)
M1_CPH: C22.1, U5.13 (CPH)
M1_CPL: C22.2, U5.14 (CPL)
M1_IMODE: R21.1, U5.7 (IMODE)
M1_IN1: U1.19 (IO11), U5.1 (EN/IN1)
M1_IN2: U1.20 (IO12), U5.2 (PH/IN2)
M1_OUTA: J3.1, U5.8 (OUT1)
M1_OUTB: J3.2, U5.10 (OUT2)
M1_VCP: C21.1, U5.12 (VCP)
M2_CPH: C32.1, U6.13 (CPH)
M2_CPL: C32.2, U6.14 (CPL)
M2_IMODE: R31.1, U6.7 (IMODE)
M2_IN1: U1.21 (IO13), U6.1 (EN/IN1)
M2_IN2: U1.22 (IO14), U6.2 (PH/IN2)
M2_OUTA: J4.1, U6.8 (OUT1)
M2_OUTB: J4.2, U6.10 (OUT2)
M2_VCP: C31.1, U6.12 (VCP)
M3_CPH: C42.1, U7.13 (CPH)
M3_CPL: C42.2, U7.14 (CPL)
M3_IMODE: R41.1, U7.7 (IMODE)
M3_IN1: U1.8 (IO15), U7.1 (EN/IN1)
M3_IN2: U1.9 (IO16), U7.2 (PH/IN2)
M3_OUTA: J5.1, U7.8 (OUT1)
M3_OUTB: J5.2, U7.10 (OUT2)
M3_VCP: C41.1, U7.12 (VCP)
M4_CPH: C52.1, U8.13 (CPH)
M4_CPL: C52.2, U8.14 (CPL)
M4_IMODE: R51.1, U8.7 (IMODE)
M4_IN1: U1.10 (IO17), U8.1 (EN/IN1)
M4_IN2: U1.11 (IO18), U8.2 (PH/IN2)
M4_OUTA: J6.1, U8.8 (OUT1)
M4_OUTB: J6.2, U8.10 (OUT2)
M4_VCP: C51.1, U8.12 (VCP)
Q1_G: Q1.1 (G), R1.1
USB_CC1: J2.A5 (CC1), R10.1
USB_CC2: J2.B5 (CC2), R11.1
USB_DN: J2.A7 (D-), J2.B7 (D-), U1.13 (USB_D-), U4.1 (I/O1), U4.6 (I/O1)
USB_DP: J2.A6 (D+), J2.B6 (D+), U1.14 (USB_D+), U4.3 (I/O2), U4.4 (I/O2)
V5_BUCK: C8.1, C9.1, D2.2 (A), L1.2, R7.1
VBAT: C1.1, C2.1, C4.1, C5.1, C6.1, C21.2, C23.1, C24.1, C31.2, C33.1, C34.1, C41.2, C43.1, C44.1, C51.2, C53.1, C54.1, F1.2, R3.1, R5.1, U2.3 (VIN), U5.11 (VM), U6.11 (VM), U7.11 (VM), U8.11 (VM)
VBAT_RAW: J1.2, Q1.2 (D)
VBAT_REV: F1.1, Q1.3 (S)
VBAT_SENSE: C3.1, R3.2, R4.1, U1.18 (IO10)
VUSB: D1.2 (A), J2.A4 (VBUS), J2.A9 (VBUS), J2.B4 (VBUS), J2.B9 (VBUS), U4.5 (VBUS)
XSHUT_B: J12.5, U1.29 (IO36)
XSHUT_F: J9.5, U1.24 (IO47)
XSHUT_FL: J8.5, U1.35 (IO42)
XSHUT_FR: J10.5, U1.25 (IO48)
XSHUT_L: J7.5, U1.34 (IO41)
XSHUT_R: J11.5, U1.28 (IO35)

Notes on the sheet:
ALIMENTACIÓN
BUCK 5 V
LDO 3,3 V
USB-C
ESP32-S3
DRIVERS COMUNES
MOTOR 1
MOTOR 2
MOTOR 3
MOTOR 4
SENSORES
MECÁNICA
BANDERAS DE ALIMENTACIÓN

Board: 2 copper layers, 109 parts (0 on the bottom side), 77 nets, no tracks yet.
