Mateosmerodes/Mini_Sumo_Robot_LHDLT/(commit log)

2026-10-06 Claude_Proyect
    crudo de claude a partir de darle toda la informacion y un .md con instrucciones concretas
    [bateria_lipo_2s.stl, bom.csv, carcasa_paredes.step, carcasa_paredes.stl, carcasa_superior.stl, carcasa_techo.step, carcasa_techo.stl, componentes_pcb.stl]
2026-10-19 ESP32-S3-DevKitC-1 completa enchufada en lugar del módulo soldado (placa base v1.1)
    El cerebro pasa a ser la ESP32-S3-DevKitC-1 entera, pinchada en tiras hembra
    de 2,54 mm sobre la placa base, a lo largo del robot y con los USB hacia la
    pared trasera.
    Electrónica (design.py, gen_lib.py, gen_pcb.py):
    - Símbolo y huella propios de la DevKitC-1; zócalo solo en los 37 pines con
    señal, para que VBAT cruce por los huecos entre filas.
    - Fuera de la placa base lo que ya trae la DevKit: módulo WROOM, USB-C y
    USBLC6, botones RESET/BOOT, WS2812 y LDO AMS1117 (109 -> 96 componentes).
    - +3V3 desde los pines 3V3 de la DevKit; pin 5V alimentado a través de D1.
    - Pinout fuera de GPIO35-37 (vale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
2026-10-19 Ficha técnica: respuestas al modelo de la competición con los cálculos
    Nuevo docs/Ficha-tecnica.md: dimensiones y masa, batería (C mínimo, fusible,
    divisor), motores y drivers (corriente de bloqueo, ITRIP), potencia máxima,
    consumo de 3,3 V, autonomía por escenarios, tabla de control y sensado e
    inspección reglamentaria. Enlazado desde el README.
    Claude-Session: https://claude.ai/code/session_01GwZkBsarwnJDbGQyuZVyuN
